hkymstr/CAN_Pressure/k_type_emf_plot.png

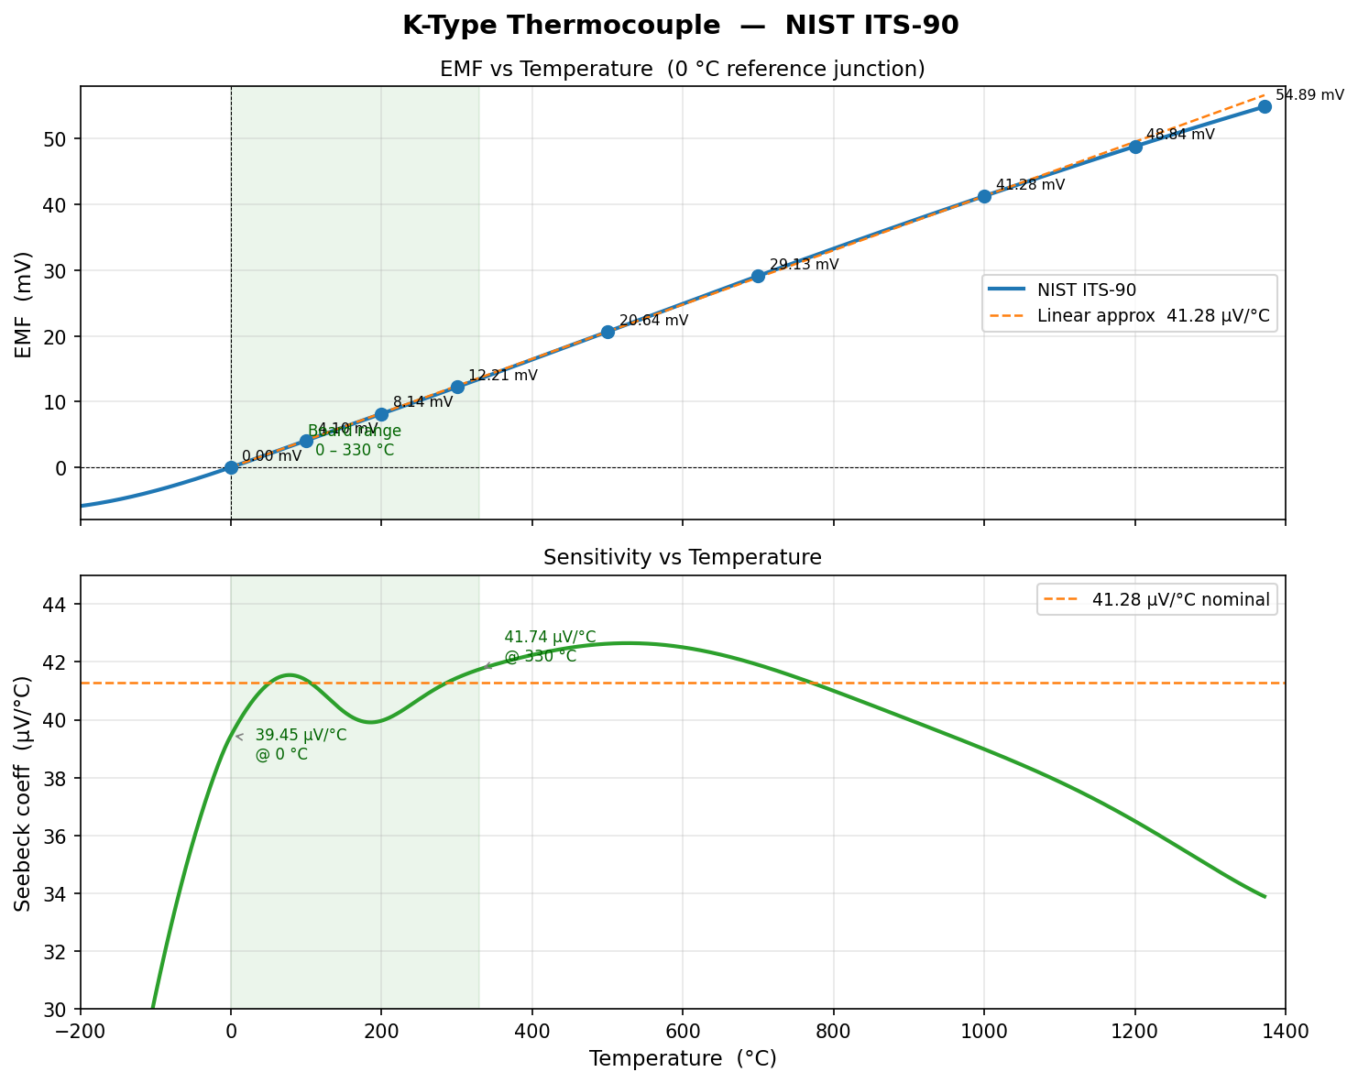
k_type_emf_plot.png
