hkymstr/CAN_Pressure/CAN_adc.pdf

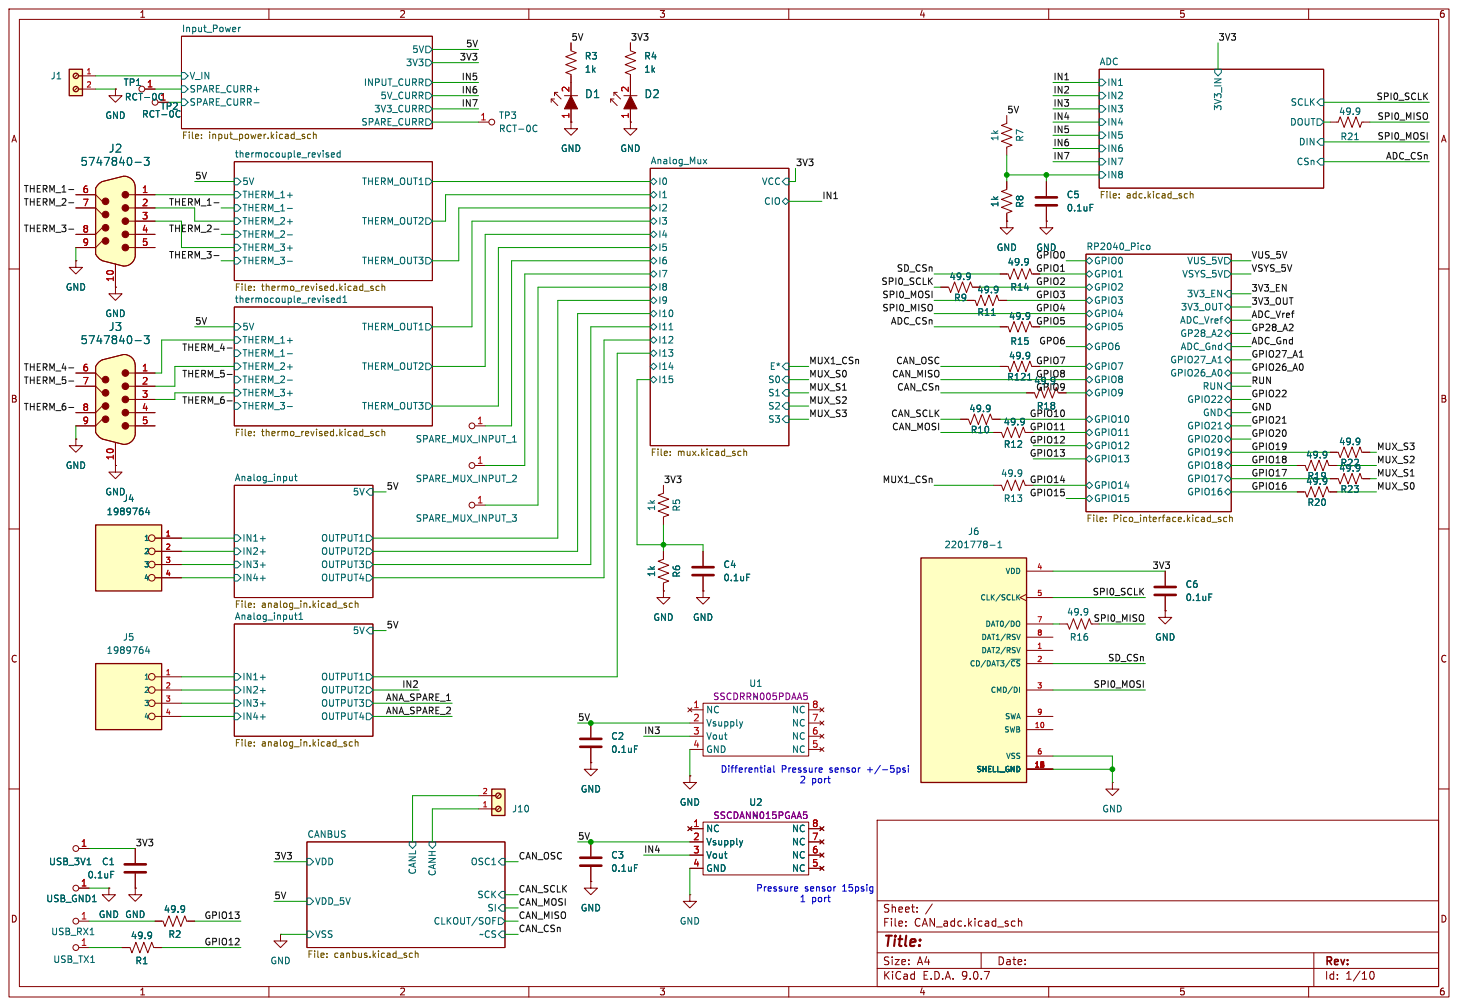
[picture p2: page 1]

Id: 1/10 Title: File: CAN_adc.kicad_sch Sheet: /

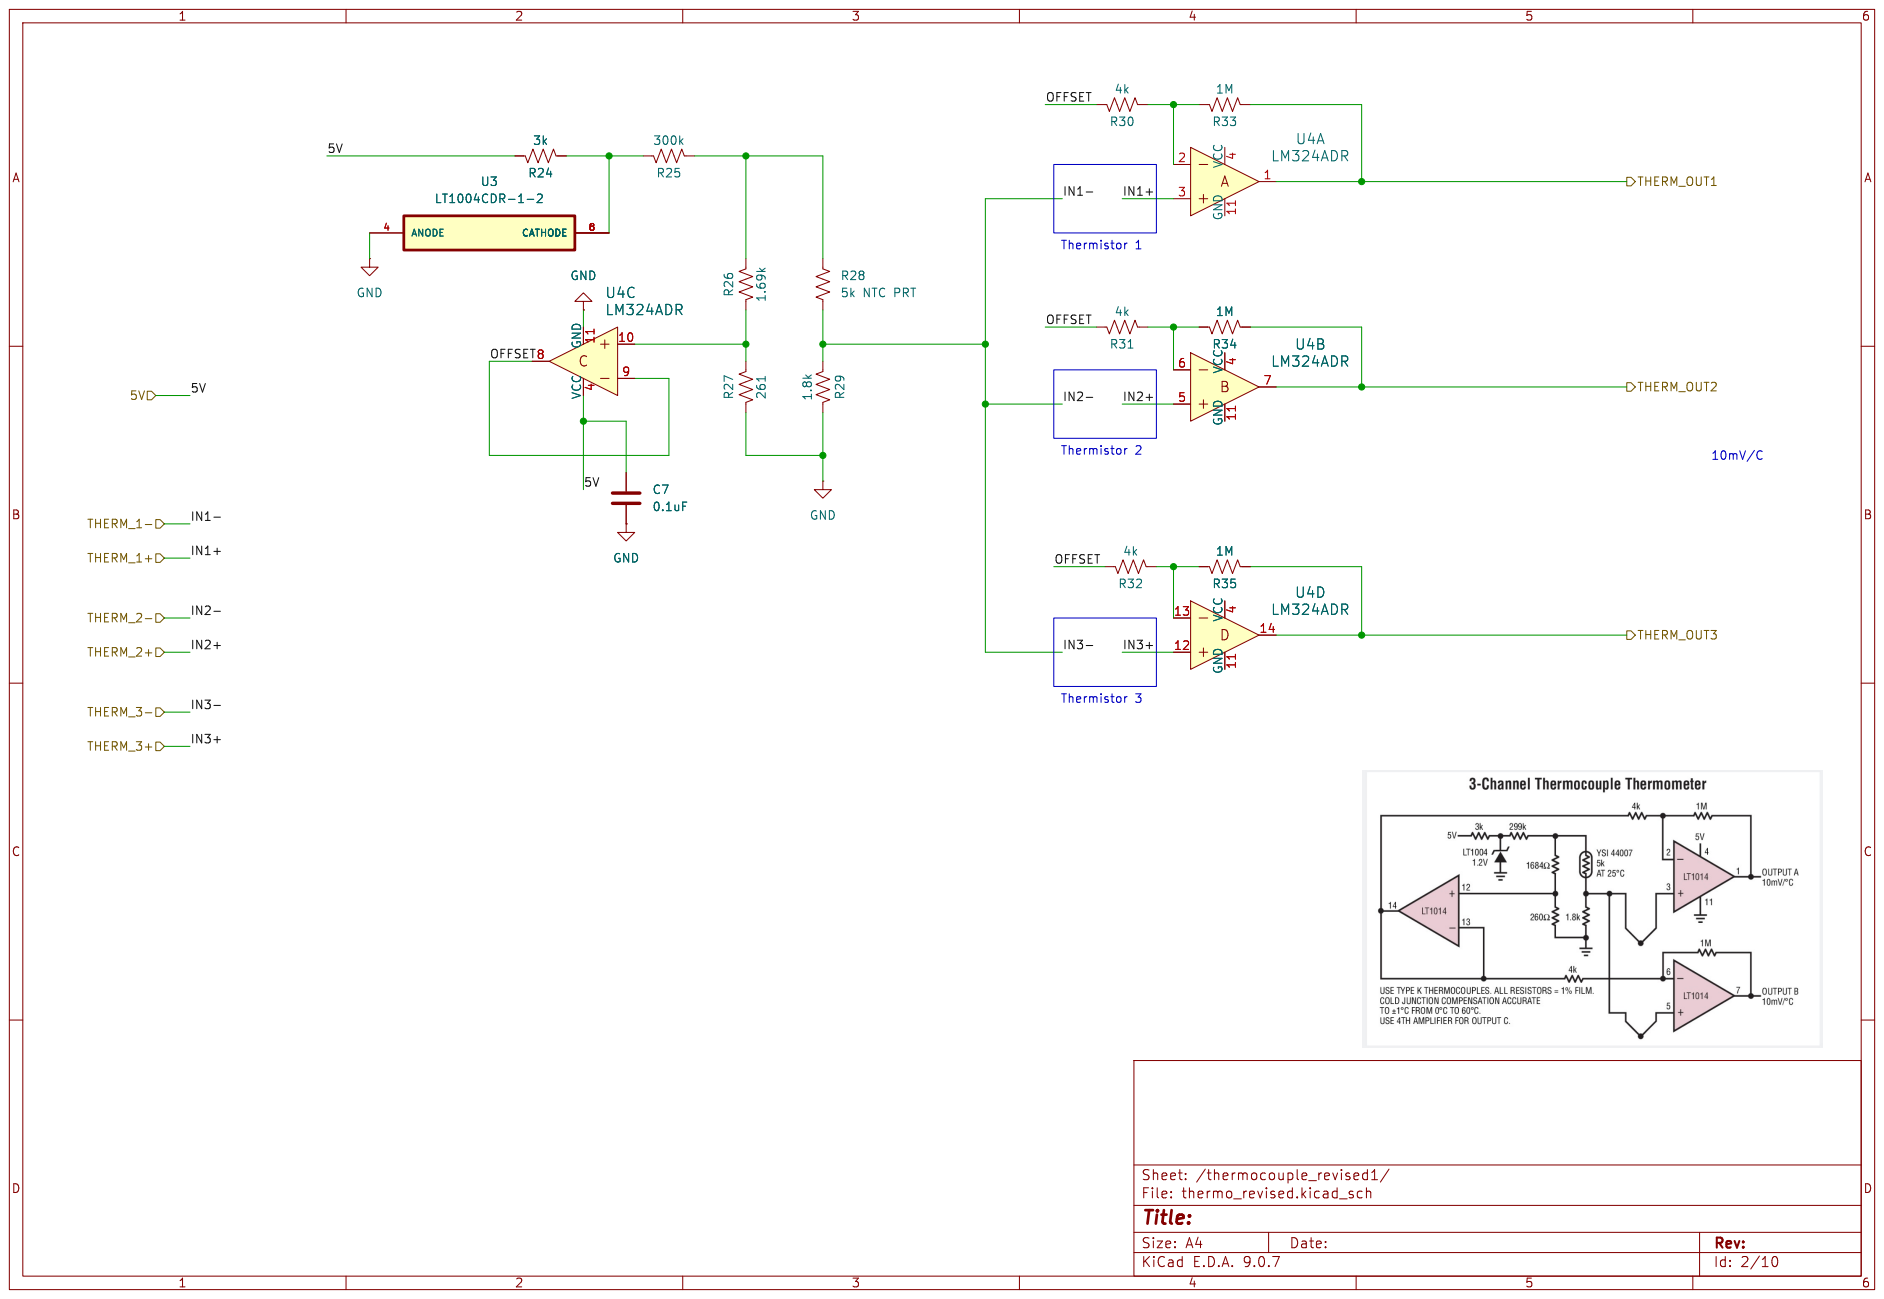
[picture p3: page 2]

Id: 2/10 Title: File: thermo_revised.kicad_sch Sheet: /thermocouple_revised1/

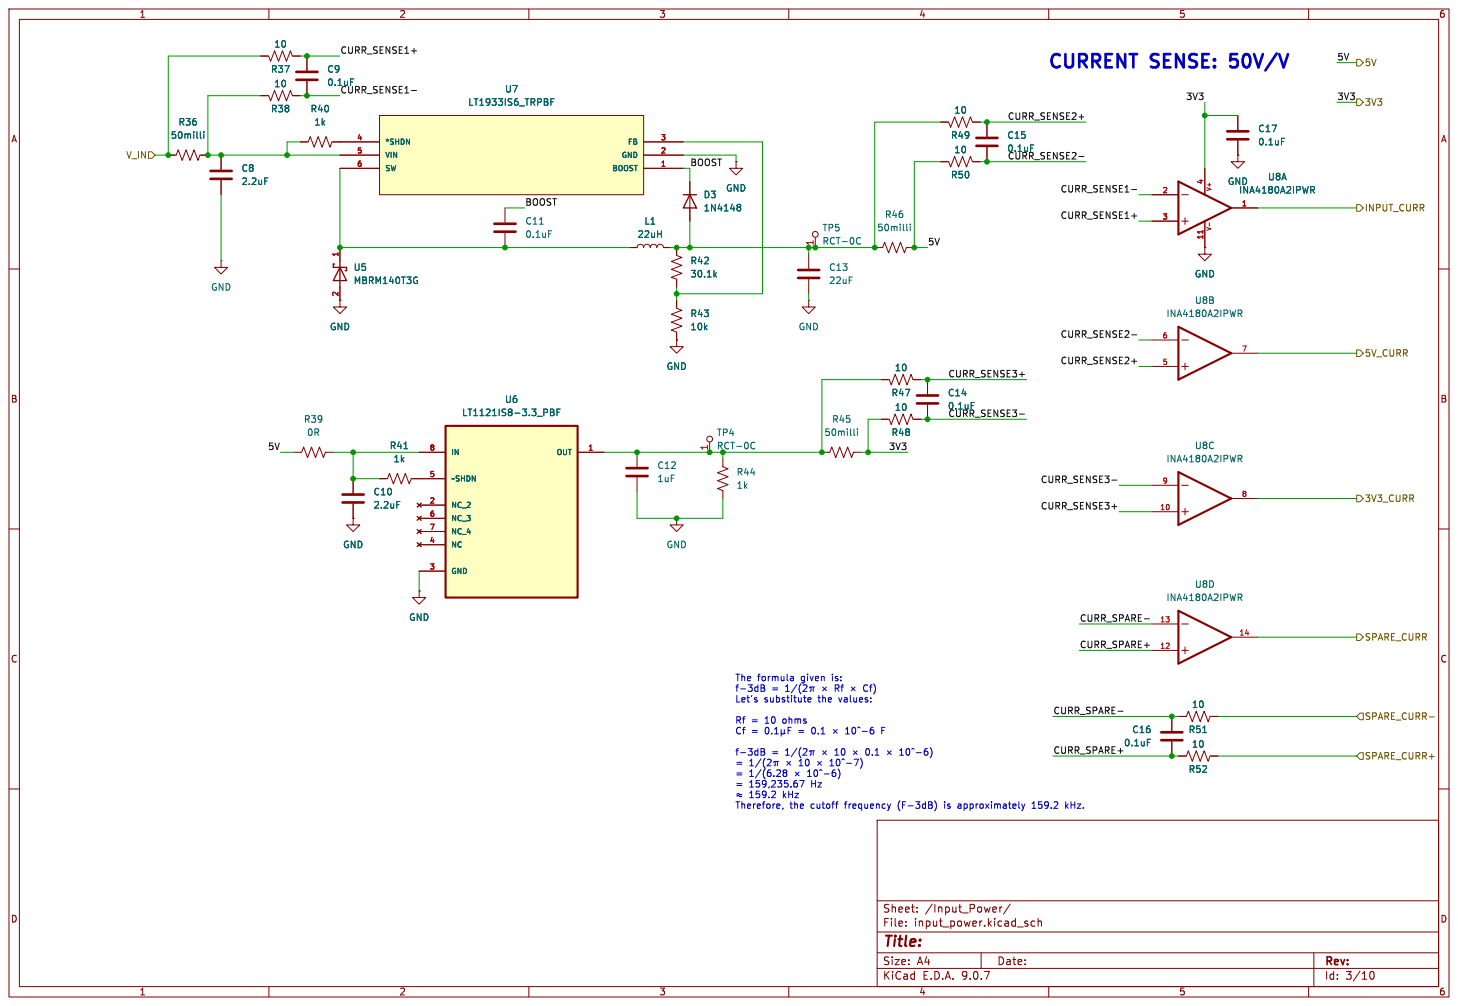
[picture p4: page 3]

Id: 3/10 Title: File: input_power.kicad_sch Sheet: /Input_Power/

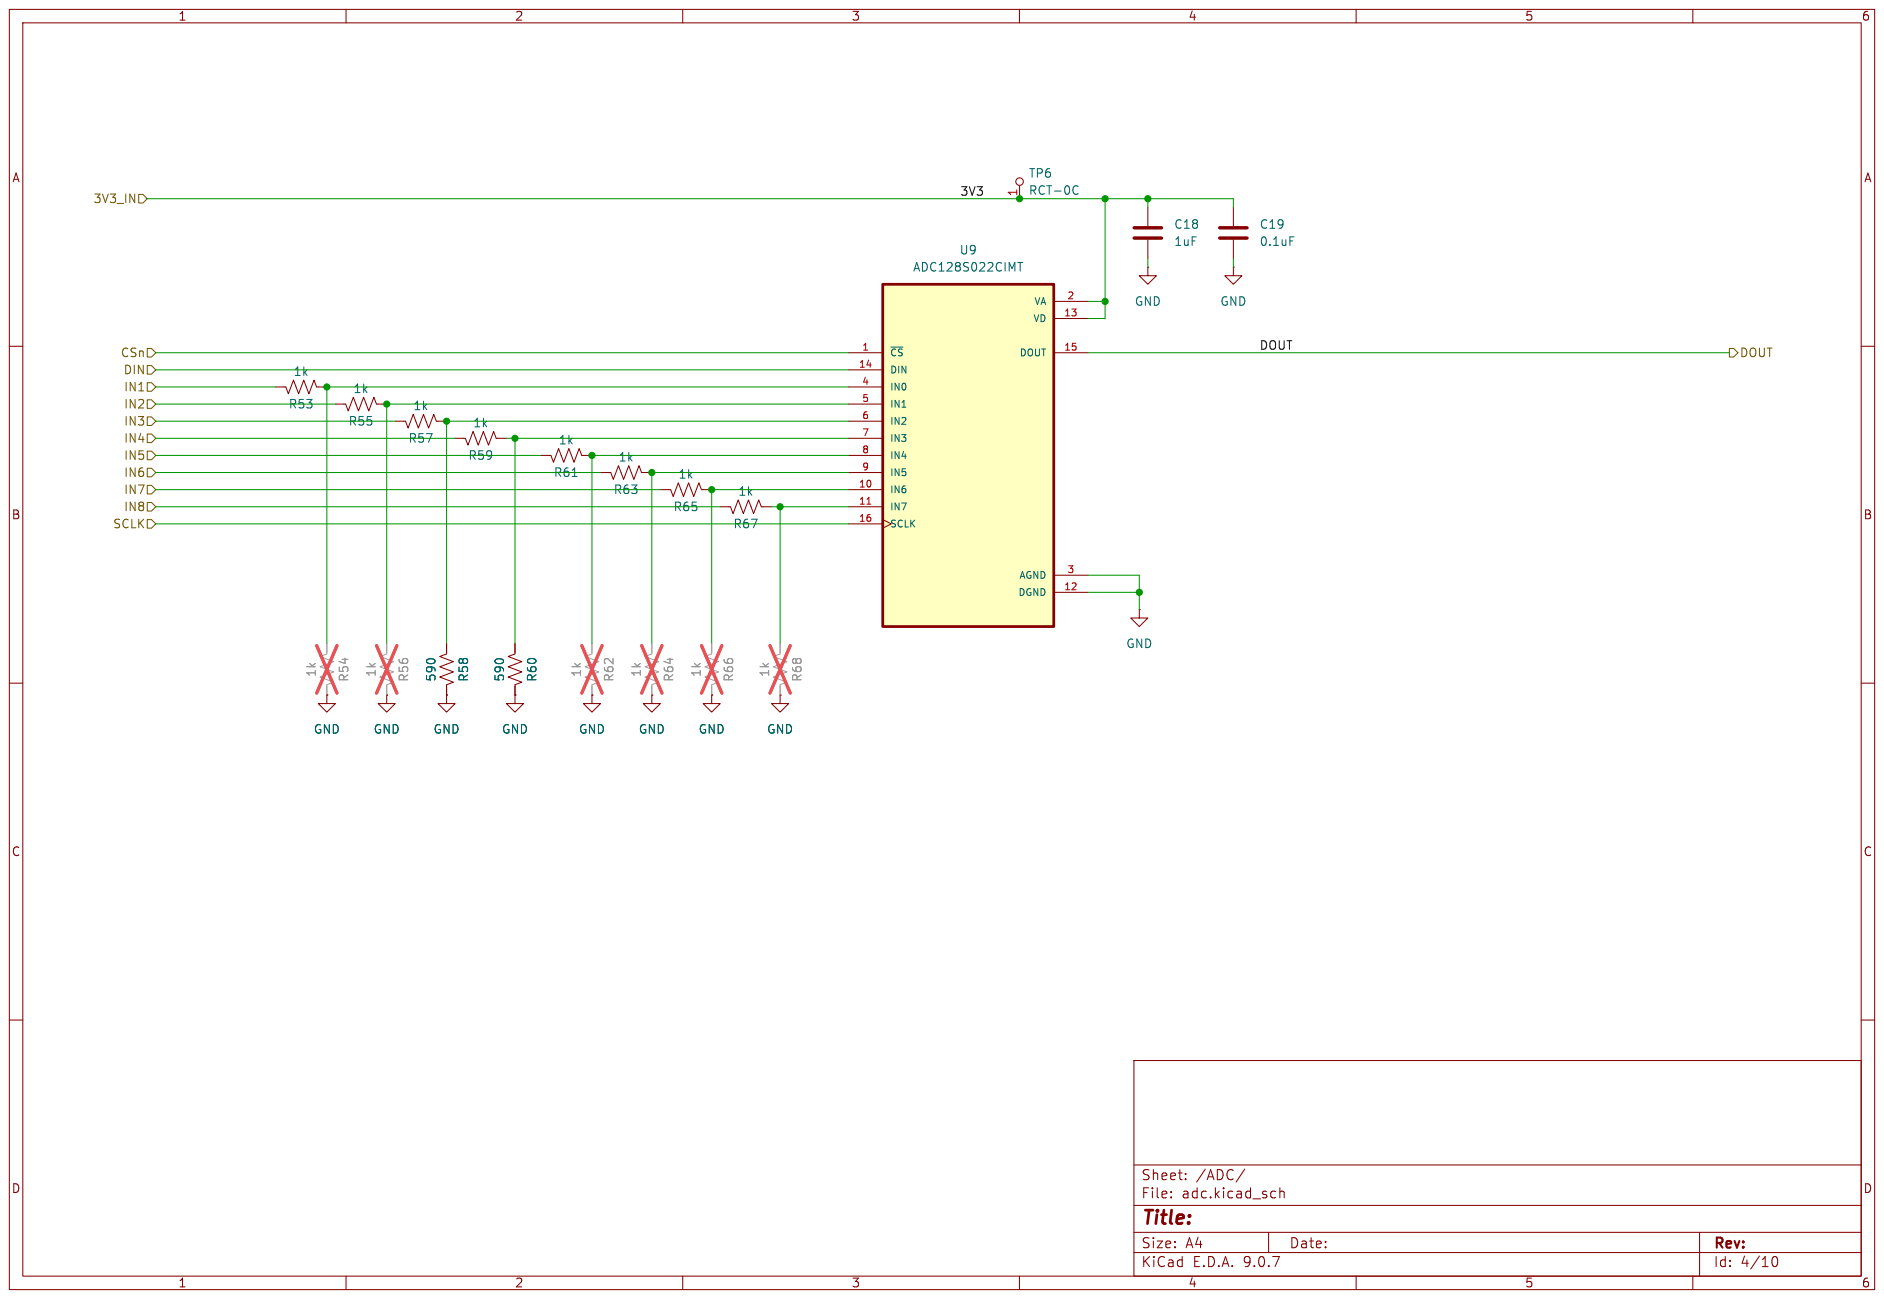
[picture p5: page 4]

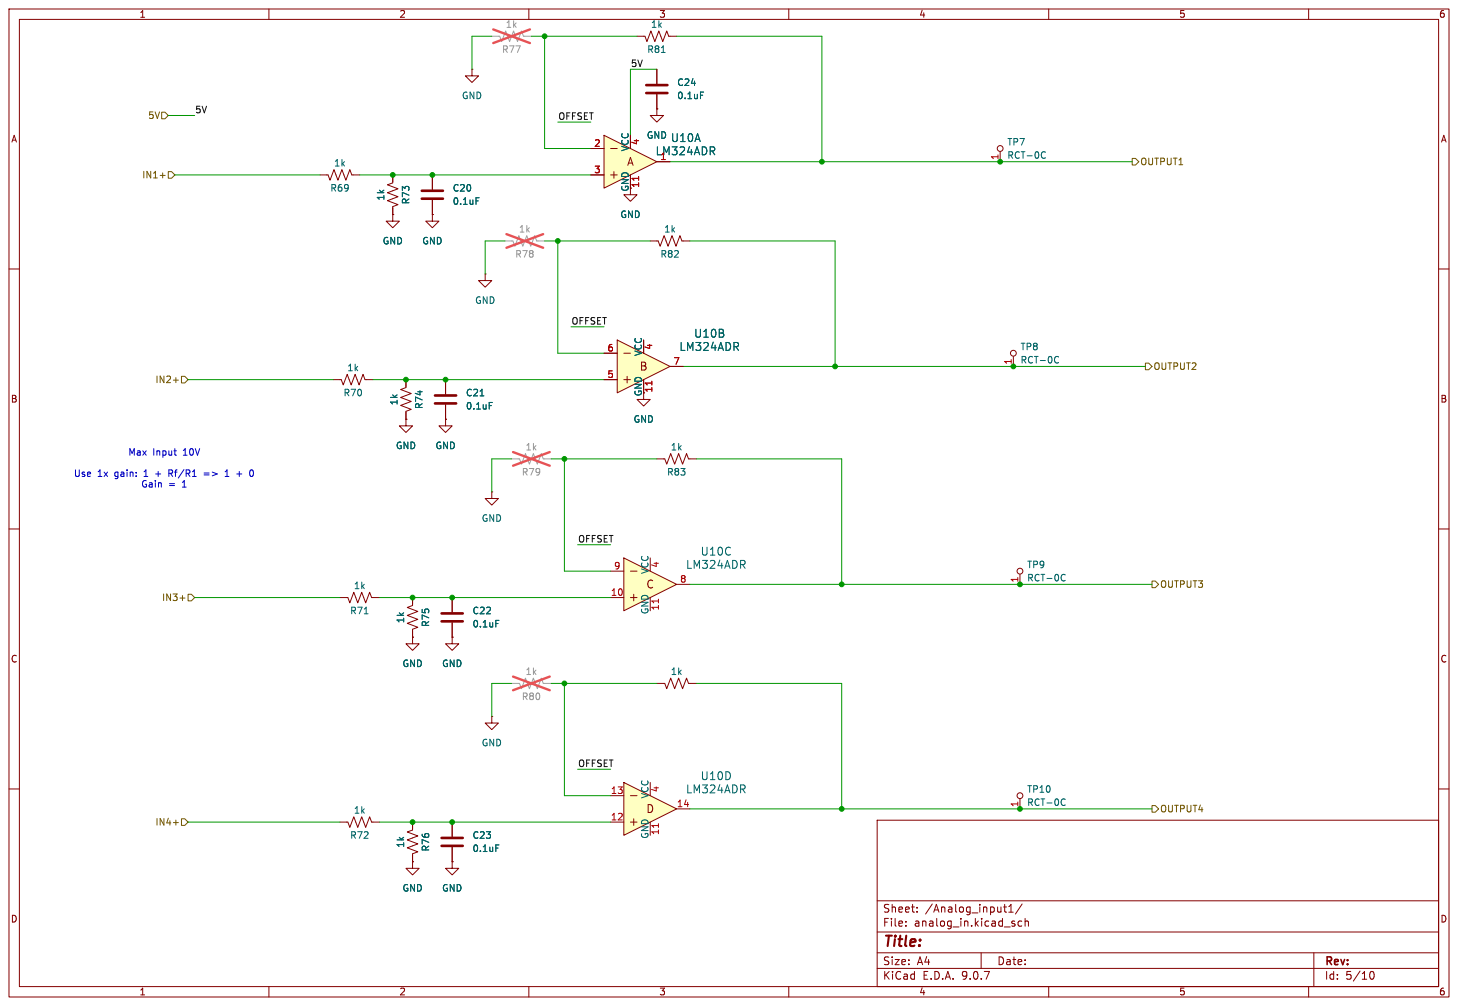
[picture p6: page 5]

Id: 5/10 Title: File: analog_in.kicad_sch Sheet: /Analog_input1/ 1k R72

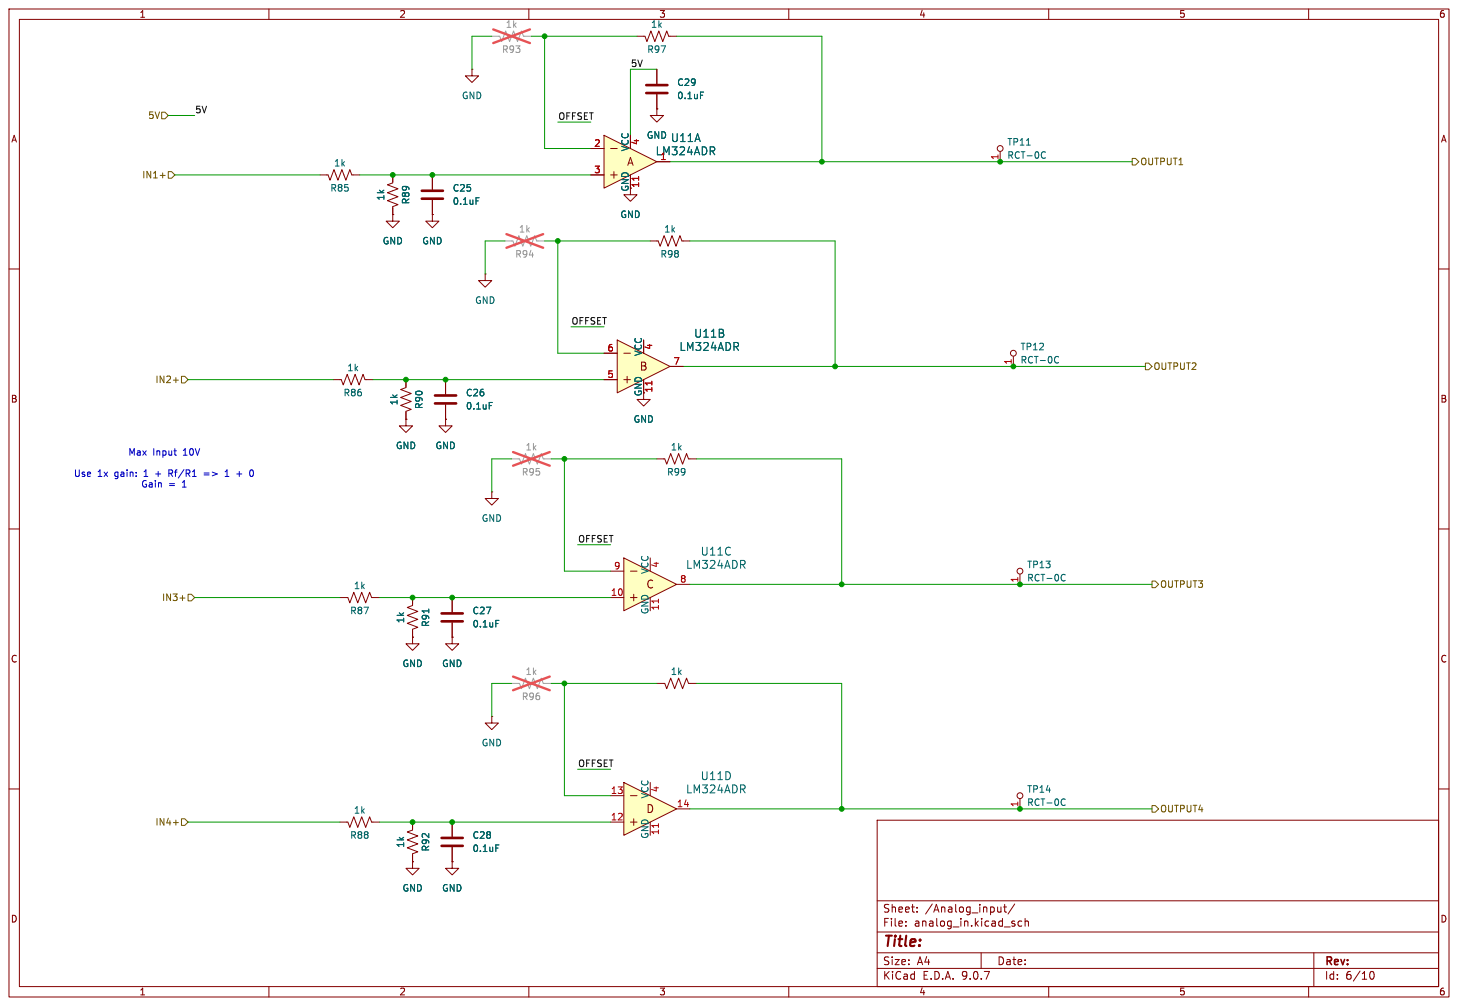
[picture p7: page 6]

Id: 6/10 Title: File: analog_in.kicad_sch Sheet: /Analog_input/ C 9

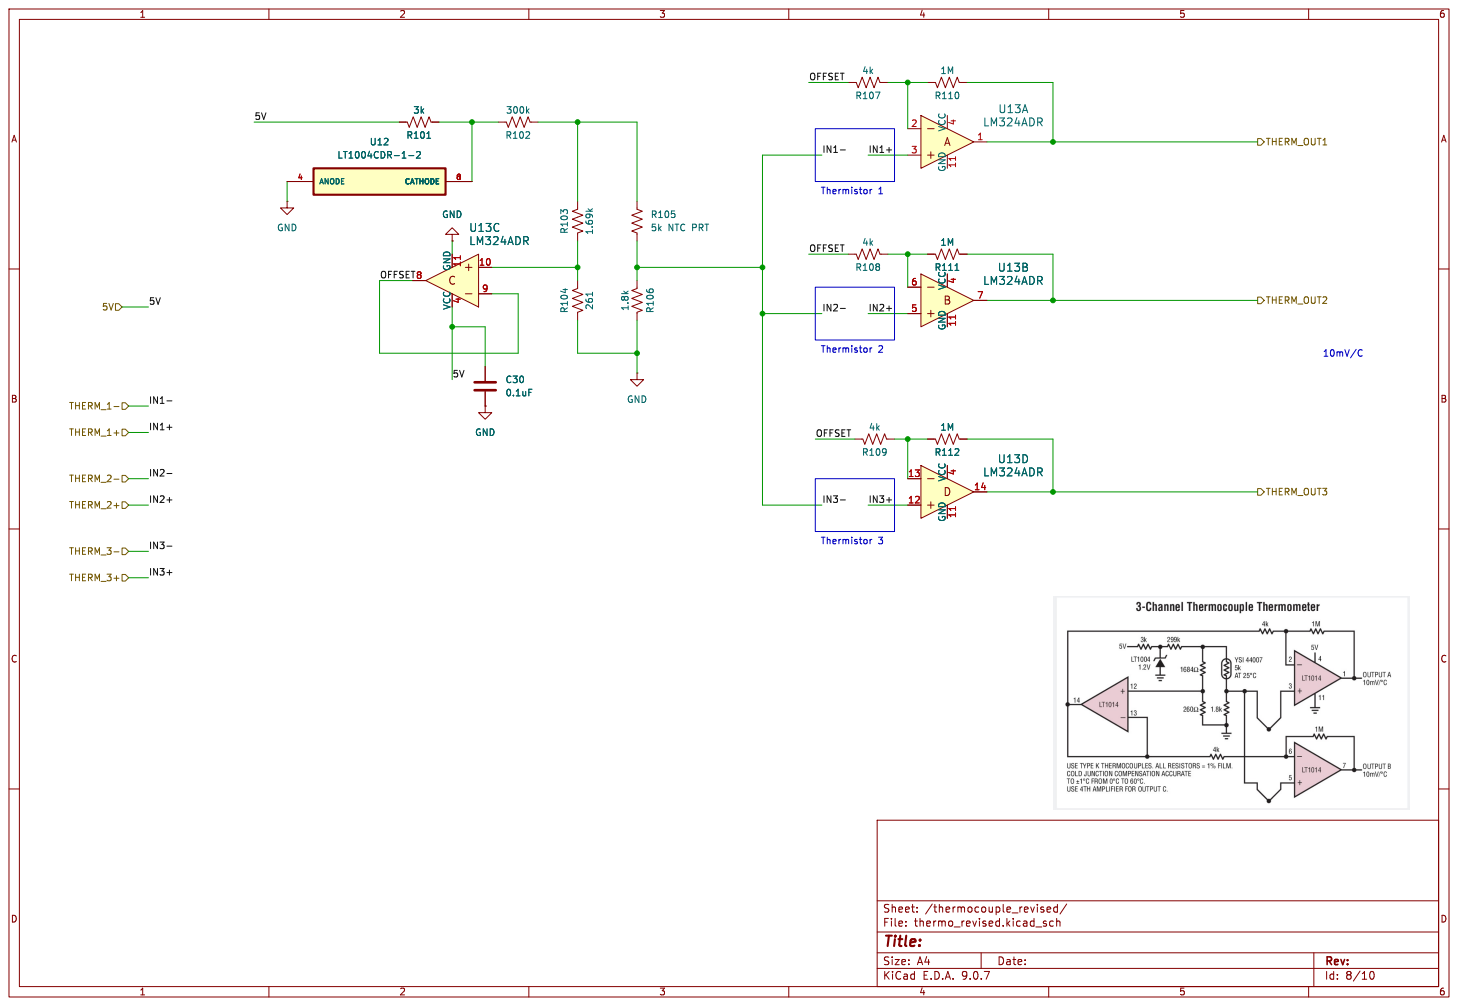
[picture p8: page 7]

Id: 8/10 Title: File: thermo_revised.kicad_sch Sheet: /thermocouple_revised/

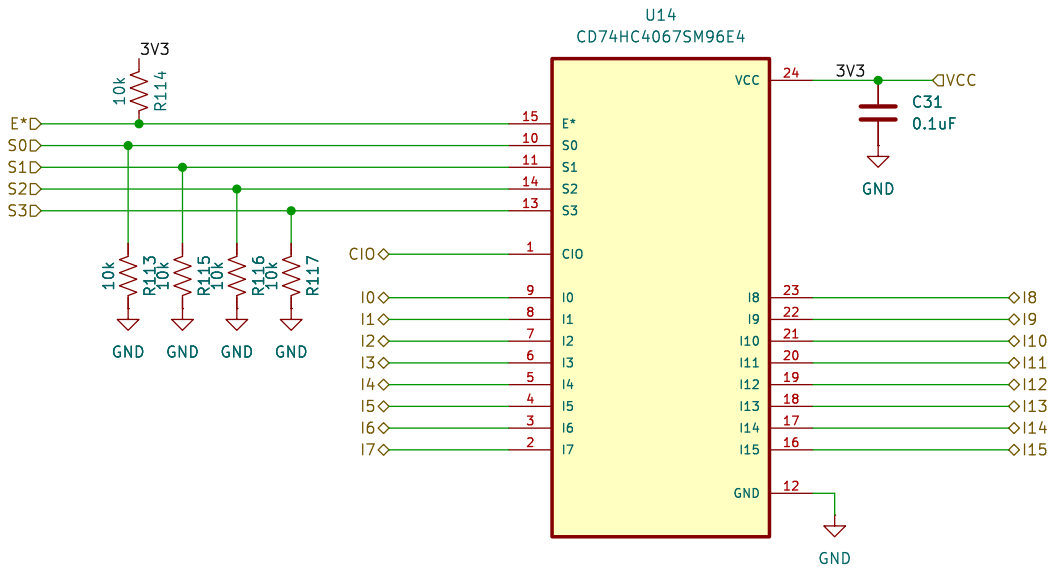
[picture p9: page 8]

Id: 9/10 Title: File: mux.kicad_sch Sheet: /Analog_Mux/ GND

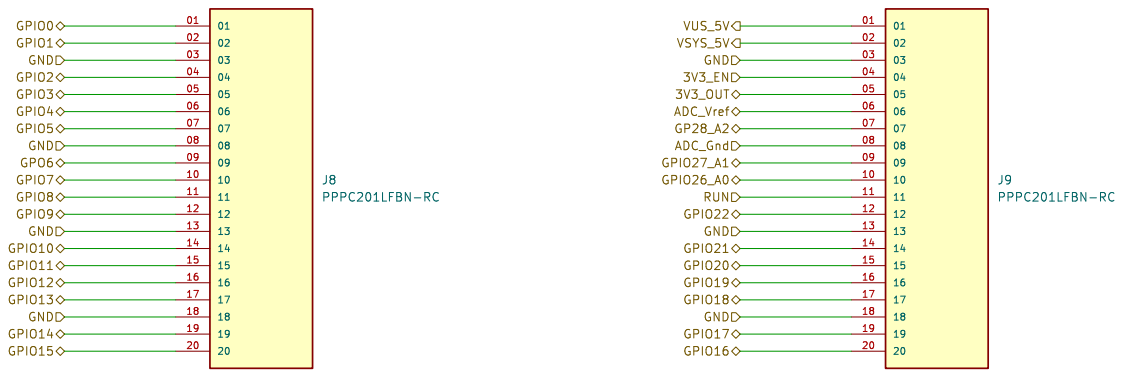
[picture p10: page 9]

3V3_OUT ADC_Vref VUS_5V GPIO16 GPIO18 GND GPIO17 GPIO19 GPIO20 GPIO21 GPIO3 GPIO15 GPIO10 GPIO12 GPIO13 GPIO14 GPIO11 GND GPIO5 GPIO2 GND GPIO4 GPIO1 GPIO0 GND GND GPIO8 GPO6 GPIO7

Id: 9/10 Title: File: Pico_interface.kicad_sch Sheet: /RP2040_Pico/

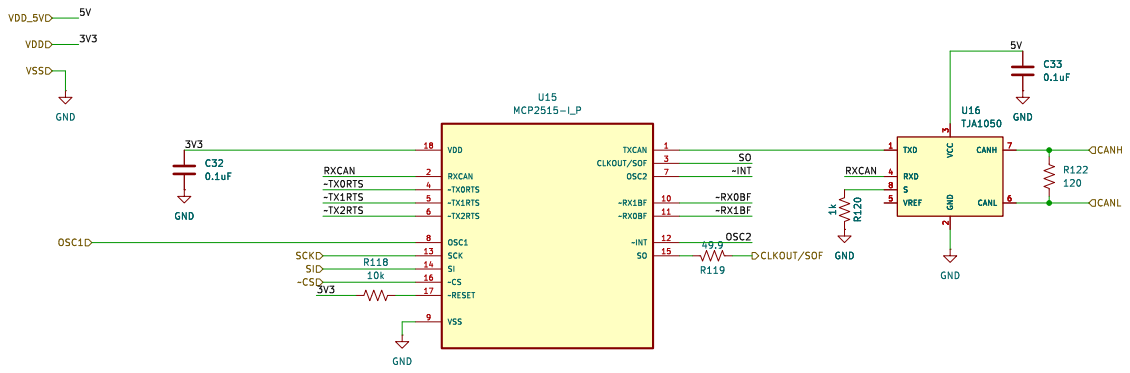
[picture p11: page 10]

2 CANH 7 CANL 6 U16 TJA1050 GND R120 1k GND

Id: 10/10 Title: File: canbus.kicad_sch Sheet: /CANBUS/ GND
