hkymstr/CAN_Pressure/can_monitor.py

#!/usr/bin/env python3
"""
CAN Pressure Board — Serial Monitor and Data Logger

Connects to the board's USB-CDC port, displays live telemetry, and logs
all data rows to a timestamped CSV file.

Data rows from the board are prefixed with '$DATA,' — all other lines
(boot messages, table display, menu text) are printed as-is and not logged.

Usage examples:
    python can_monitor.py --port COM3
    python can_monitor.py --port /dev/ttyACM0 --output run1.csv
    python can_monitor.py --port COM3 --quiet
    python can_monitor.py --list

Requirements:
    pip install pyserial
"""

import argparse
import csv
import datetime
import sys
import time

try:
    import serial
    import serial.tools.list_ports
except ImportError:
    print("ERROR: pyserial not installed.  Run:  pip install pyserial")
    sys.exit(1)

# ---------------------------------------------------------------------------
# Channel metadata — must match firmware _OBD_CHANNELS
# ---------------------------------------------------------------------------

CHANNELS = [
    # CH1–6: thermocouple inputs (10 mV/°C amp → 0–330 °C over 0–3.3 V)
    ("Temperature_1",  "C",      0,  330),
    ("Temperature_2",  "C",      0,  330),
    ("Temperature_3",  "C",      0,  330),
    ("Temperature_4",  "C",      0,  330),
    ("Temperature_5",  "C",      0,  330),
    ("Temperature_6",  "C",      0,  330),
    # CH7–9: spare MUX inputs (unconnected)
    ("Spare_1",        "V",      0,  3.3),
    ("Spare_2",        "V",      0,  3.3),
    ("Spare_3",        "V",      0,  3.3),
    # CH10–14: analog inputs (0.5 resistor divider → ×2 → 0–6.6 V)
    ("Analog_In_1",    "V",      0,  6.6),
    ("Analog_In_2",    "V",      0,  6.6),
    ("Analog_In_3",    "V",      0,  6.6),
    ("Analog_In_4",    "V",      0,  6.6),
    ("Analog_In_5",    "V",      0,  6.6),
    # CH15: spare (unused)
    ("Spare_4",        "V",      0,  3.3),
    # CH16: 3.3 V rail monitor via 0.5 resistor divider (×2 to recover voltage)
    ("Voltage_3V3",    "V",      0,  6.6),
    # CH17: analog input (cont., 0.5 resistor divider → ×2 → 0–6.6 V)
    ("Analog_In_6",    "V",      0,  6.6),
    # CH18: differential pressure, 0.5–4.5 V output, 2.5 V = 0 psid, ±30 psi span
    #       1 kΩ/590 Ω divider → k=0.37107; at 2.5 V sensor → 0.927 V ADC (raw≈1151)
    ("Diff_Pressure",  "psi",  -37.5,  95.898),
    # CH19: gauge pressure sensor, 0–4 V output, 0–15 psi, 1 kΩ/590 Ω divider
    ("Pressure",       "psi",   -1.875,  31.474),
    # CH20–22: current monitors (INA4180A2, 50 V/V, 50 mΩ shunt → 0–1.32 A)
    ("Input_Current",  "A",      0, 1.32),
    ("Curr_5V",        "A",      0, 1.32),
    ("Curr_3V3",       "A",      0, 1.32),
    # CH23: 5 V rail via 0.5 divider (×2 recovery → 0–6.6 V)
    ("Voltage_5V",     "V",      0,  6.6),
]

NUM_CH       = len(CHANNELS)
CH_NAMES     = [c[0] for c in CHANNELS]
CH_UNITS     = [c[1] for c in CHANNELS]
CH_MINS      = [c[2] for c in CHANNELS]
CH_MAXS      = [c[3] for c in CHANNELS]

# Indices used for derived power calculations
IDX_VOLT_5V  = 22   # CH23 Voltage_5V
IDX_CURR_5V  = 20   # CH21 Curr_5V
IDX_VOLT_3V3 = 15   # CH16 Voltage_3V3
IDX_CURR_3V3 = 21   # CH22 Curr_3V3

# Compact display indices (updated to match current channel map)
IDX_TEMP1    = 0    # CH1  Temperature_1
IDX_DIFF_P   = 17   # CH18 Diff_Pressure
IDX_PRESS    = 18   # CH19 Pressure

# Channel labels per CAN frame (4 channels × uint16 big-endian = 8 bytes each)
_CAN_FRAME_LABELS = [
    "Temp_1..4",
    "Temp_5..6, Spare_1..2",
    "Spare_3, Analog_1..3",
    "Analog_4..5, Spare_4, V_3V3",
    "Analog_6, dP, P, I_in",
    "I_5V, I_3V3, V_5V, pad",
]

# ---------------------------------------------------------------------------
# Helpers
# ---------------------------------------------------------------------------

def raw_to_scaled(raw, mn, mx):
    """Convert 12-bit raw count to engineering units."""
    if mx == mn:
        return None
    return mn + (int(raw) / 4095.0) * (mx - mn)


def compute_power(scaled_vals):
    """Return (power_5v_W, power_3v3_W) derived from voltage and current channels."""
    v5   = scaled_vals[IDX_VOLT_5V]
    i5   = scaled_vals[IDX_CURR_5V]
    v3   = scaled_vals[IDX_VOLT_3V3]
    i3   = scaled_vals[IDX_CURR_3V3]
    p5   = v5  * i5  if (v5  is not None and i5  is not None) else None
    p3   = v3  * i3  if (v3  is not None and i3  is not None) else None
    return p5, p3


def format_can_frames(raw_vals):
    """Reconstruct 6 CAN frames (0x200–0x205) from raw ADC values as displayable tuples."""
    frames = []
    for msg_idx in range(6):
        payload = []
        for j in range(4):
            ch = msg_idx * 4 + j
            val = int(raw_vals[ch]) if ch < NUM_CH else 0
            payload.append((val >> 8) & 0xFF)
            payload.append(val & 0xFF)
        hex_str = " ".join(f"{b:02X}" for b in payload)
        frames.append((f"0x{0x200 + msg_idx:03X}", hex_str, _CAN_FRAME_LABELS[msg_idx]))
    return frames


def list_ports():
    ports = list(serial.tools.list_ports.comports())
    if not ports:
        print("No serial ports found.")
        return
    print("Available serial ports:")
    for p in sorted(ports):
        print(f"  {p.device:<15}  {p.description}")


def open_port(port, baud, retries=5):
    for attempt in range(1, retries + 1):
        try:
            ser = serial.Serial(port, baud, timeout=2)
            print(f"Connected to {port} at {baud} baud.")
            return ser
        except serial.SerialException as exc:
            wait = 2 ** attempt
            print(f"  [{attempt}/{retries}] {exc}  — retrying in {wait}s")
            if attempt < retries:
                time.sleep(wait)
    print("Could not open port.  Exiting.")
    sys.exit(1)


def auto_filename():
    ts = datetime.datetime.now().strftime("%Y%m%d_%H%M%S")
    return f"can_pressure_{ts}.csv"


# ---------------------------------------------------------------------------
# Live display helpers
# ---------------------------------------------------------------------------

_CLEAR = "\033[2J\033[H"   # ANSI clear screen + cursor home

def print_live_table(timestamp, raw_vals, fw_version=None):
    """Render a full-screen table of all 23 channels plus derived power rows."""
    sep  = "=" * 62
    dash = "-" * 62
    print(_CLEAR, end="")
    print(sep)
    ver_str = f"  |  FW {fw_version}" if fw_version else ""
    print(f"  CAN Pressure Board  |  {timestamp}{ver_str}")
    print(sep)
    print(f"  {'CH':>2}  {'Channel':<18}  {'Raw':>5}  {'Value':>10}  Unit")
    print(dash)
    scaled_vals = [raw_to_scaled(raw_vals[i], CH_MINS[i], CH_MAXS[i])
                   for i in range(NUM_CH)]
    for i, raw in enumerate(raw_vals):
        scaled  = scaled_vals[i]
        val_str = f"{scaled:10.3f}" if scaled is not None else f"{'---':>10}"
        print(f"  {i+1:>2}  {CH_NAMES[i]:<18}  {int(raw):>5}  {val_str}  {CH_UNITS[i]}")
    print(dash)
    p5, p3 = compute_power(scaled_vals)
    p5_str = f"{p5:10.3f}" if p5 is not None else f"{'---':>10}"
    p3_str = f"{p3:10.3f}" if p3 is not None else f"{'---':>10}"
    print(f"  {'':2}  {'Power_5V':<18}  {'':>5}  {p5_str}  W")
    print(f"  {'':2}  {'Power_3V3':<18}  {'':>5}  {p3_str}  W")
    print(dash)
    print(f"  CAN Bus Stream  (0x200–0x205 @ 500 kbps, 4 ch × uint16 big-endian)")
    print(dash)
    for can_id_str, hex_str, label in format_can_frames(raw_vals):
        print(f"  {can_id_str}  {hex_str}  {label}")
    print(sep)


def print_live_compact(timestamp, raw_vals, row_count):
    """One-line summary printed inline (for non-ANSI terminals)."""
    scaled = [raw_to_scaled(raw_vals[i], CH_MINS[i], CH_MAXS[i]) for i in range(NUM_CH)]
    temp1  = scaled[IDX_TEMP1]
    dp     = scaled[IDX_DIFF_P]
    press  = scaled[IDX_PRESS]
    p5, p3 = compute_power(scaled)
    t_str  = f"{temp1:5.1f}C"   if temp1 is not None else "  --- "
    dp_str = f"{dp:5.2f}psi"    if dp    is not None else " ---  "
    p_str  = f"{press:6.1f}psi" if press is not None else "  --- "
    p5_str = f"{p5:5.2f}W"      if p5   is not None else " ---  "
    p3_str = f"{p3:5.2f}W"      if p3   is not None else " ---  "
    print(f"\r{timestamp}  T1={t_str}  dP={dp_str}  P={p_str}  "
          f"P5={p5_str}  P3={p3_str}  [{row_count}]",
          end="", flush=True)


# ---------------------------------------------------------------------------
# Main
# ---------------------------------------------------------------------------

def run(port, baud, output_file, quiet, full_screen):
    ser = open_port(port, baud)

    if output_file is None:
        output_file = auto_filename()

    print(f"Logging to: {output_file}")
    if not quiet:
        mode = "full-screen table" if full_screen else "compact one-line"
        print(f"Display:    {mode}")
    print("Press Ctrl-C to stop.\n")

    row_count  = 0
    fw_version = None

    with open(output_file, "w", newline="") as f:
        writer = csv.writer(f)
        # Header: Timestamp + one column per channel (raw) + one per channel (scaled)
        raw_header    = [f"{n}_raw" for n in CH_NAMES]
        scaled_header = [f"{n}_{u}" if u else n for n, u, *_ in CHANNELS]
        writer.writerow(["Timestamp"] + raw_header + scaled_header +
                        ["Power_5V_W", "Power_3V3_W"])
        f.flush()

        try:
            while True:
                try:
                    line = ser.readline().decode("utf-8", errors="replace").rstrip("\r\n")
                except serial.SerialException:
                    print("\nPort disconnected — reconnecting...")
                    ser.close()
                    time.sleep(2)
                    ser = open_port(port, baud)
                    continue

                if not line:
                    continue

                if line.startswith("$DATA,"):
                    # Parse: $DATA,<timestamp>,<v0>,<v1>,...,<v22>
                    parts = line[6:].split(",")
                    if len(parts) < NUM_CH + 1:
                        continue   # malformed line

                    timestamp = parts[0]
                    try:
                        raw_vals = [int(p) for p in parts[1 : NUM_CH + 1]]
                    except ValueError:
                        continue

                    scaled_vals = [
                        raw_to_scaled(r, CH_MINS[i], CH_MAXS[i])
                        for i, r in enumerate(raw_vals)
                    ]
                    scaled_strs = [
                        f"{v:.4f}" if v is not None else "" for v in scaled_vals
                    ]
                    p5, p3 = compute_power(scaled_vals)
                    p5_str = f"{p5:.4f}" if p5 is not None else ""
                    p3_str = f"{p3:.4f}" if p3 is not None else ""

                    writer.writerow([timestamp] + raw_vals + scaled_strs +
                                    [p5_str, p3_str])
                    f.flush()
                    row_count += 1

                    if not quiet:
                        if full_screen:
                            print_live_table(timestamp, raw_vals, fw_version)
                        else:
                            print_live_compact(timestamp, raw_vals, row_count)

                elif line.startswith("$CAN,"):
                    parts = line[5:].split(",", 2)
                    if len(parts) == 3 and parts[1].strip() == "0x1FF":
                        try:
                            hb = parts[2].strip().split()
                            fw_version = "v{}.{}.{}".format(
                                int(hb[0], 16), int(hb[1], 16), int(hb[2], 16))
                        except (IndexError, ValueError):
                            pass

                else:
                    # Non-data line (boot message, table header, menu text)
                    if not quiet:
                        if not full_screen:
                            print()   # newline after compact row
                        print(line)

        except KeyboardInterrupt:
            if not quiet and not full_screen:
                print()
            print(f"\nStopped.  {row_count} rows written to {output_file}")
        finally:
            ser.close()


def main():
    parser = argparse.ArgumentParser(
        description="CAN Pressure Board — serial monitor and data logger",
        formatter_class=argparse.RawDescriptionHelpFormatter,
        epilog="""
examples:
  %(prog)s --port COM3
  %(prog)s --port /dev/ttyACM0 --output run1.csv
  %(prog)s --port COM3 --full-screen
  %(prog)s --port COM3 --quiet --output background.csv
  %(prog)s --list
        """)

    parser.add_argument("--port",  "-p",
                        help="Serial port  (e.g. COM3 or /dev/ttyACM0)")
    parser.add_argument("--baud",  "-b", type=int, default=115200,
                        help="Baud rate (default: 115200)")
    parser.add_argument("--output", "-o",
                        help="Output CSV file  (default: auto-timestamped)")
    parser.add_argument("--quiet", "-q", action="store_true",
                        help="Suppress all screen output — log only")
    parser.add_argument("--full-screen", "-f", action="store_true",
                        help="Clear screen and redraw full channel table each second")
    parser.add_argument("--list", "-l", action="store_true",
                        help="List available serial ports and exit")

    args = parser.parse_args()

    if args.list:
        list_ports()
        return

    if not args.port:
        parser.print_help()
        print("\nERROR: --port is required.")
        print()
        list_ports()
        sys.exit(1)

    run(args.port, args.baud, args.output, args.quiet, args.full_screen)


if __name__ == "__main__":
    main()
