hkymstr/CAN_Pressure/(commit log)

2025-02-23 KiCAD file for layout
2025-03-02 Added CANBUS_pressure_monitor.drawio
2025-03-02 Create software_can_micro_python
    micro python code for raspberry pi pico
2025-03-02 Create software_can_circuit_python.py
    circuit python implmentation
2026-05-05 Implement all 8 firmware requirements
    - Fix CAN IDs to 0x200-0x205 (was 0x100+)
    - Fix MCP2515 bit timing: correct CNF1/2/3 for 500/250/125/1000 kbps @ 8 MHz
    - Enforce 5 Hz sampling with ticks_diff timing (was free-running)
    - Fix ADC channel index bug: adc_data[0..15]=MUX, [16..22]=direct ADC IN1-7
    - Fix ADC128S022 command byte: channel in DIN[13:11] not DIN[14:12]
    - Fix SPI ADC reads to use write_readinto (full-duplex); prime pipeline per MUX switch
    - Fix MCP2515 TX: single CS transaction for LOAD_TX0 + header + data
    - Add USB-CDC menu (Enter key): set RTC time, set CAN baud rate
    - Add RP2040 RTC timestamping on all log rows
    - Fix SD log format to CAN log: Time Stamp,ID,Extended,Bus,LEN,D1..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
    [software_can_micro_python.py]
2026-05-05 Add comprehensive README documentation
    Covers pin assignments, channel map, CAN frame layout, SD log format,
    OBD file format, firmware defaults, and menu interface usage.
    https://claude.ai/code/session_01437NfnwRvxVYxq9oxSTwrE
2026-05-05 Expand README with full design documentation
    Adds complete hardware architecture, BOM for all key ICs, connector
    reference table, detailed signal chain description, full 23-channel map
    with sensor assignments and engineering-unit ranges, CAN frame layout,
    SD card file formats with decode examples, power supply topology,
    MCP2515 bit-timing derivation, firmware deploy instructions, and
    serial menu usage guide.
    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
2026-05-06 Add 1 Hz serial telemetry display and PC monitor/logger
    Firmware (software_can_micro_python.py):
    - Add DISP_OFF/TABLE/CSV/BOTH display modes, default OFF
    - Print human-readable channel table at 1 Hz (DISP_TABLE)
    - Print $DATA,<timestamp>,<CH1..23> CSV line at 1 Hz (DISP_CSV)
    - DISP_BOTH prints both formats each second
    - Add menu option 3 to cycle display mode; Resume moves to option 4
    - Display timer resets cleanly after menu exit
    PC monitor (can_monitor.py):
    - Parses $DATA, prefixed lines from USB-CDC port
    - Logs timestamped CSV with raw counts + scaled engineering values
    - --full-screen: clears terminal and redraws complete 23-channel table
    - Default compact mode: one rolling line showing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
    [can_monitor.py, software_can_micro_python.py]
2026-05-06 Fix SPI0 corruption when SD card is absent
    sdcard.SDCard() reconfigures the SPI0 bus during its init sequence.
    When no SD card is installed the init raises an exception but leaves
    SPI0 in a wrong baudrate/mode, causing all ADC128S022 reads to return
    0. Reinitialise SPI0 in the except block so the ADC works regardless
    of SD card presence.
    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
    [software_can_micro_python.py]
2026-05-06 Harden ADC reads and add diagnostic script
    - Move sdcard import inside try/except so a missing sdcard.py no
    longer crashes the whole firmware at import time
    - Move SPI0 reinitialisation to a finally block so it always runs
    after _init_sd(), whether the SD card succeeds or fails
    - Fix direct ADC channel reads (IN1-IN7) to use prime+read like
    MUX channels, avoiding any pipeline off-by-one
    - Print firmware version and config at startup for easy confirmation
    - Add test_adc.py standalone diagnostic (mpremote run test_adc.py)
    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
    [software_can_micro_python.py, test_adc.py]
2026-05-06 Add hardware-level ADC diagnostic phases to test_adc.py
    Phase 1 reads MISO as plain GPIO with/without pull to reveal if
    the line is stuck low independent of SPI. Phase 2 compares raw
    SPI bytes with ADC_CS, SD_CS, and no CS asserted to isolate which
    chip (if any) is responding. Phase 3 sweeps multiple SPI speeds.
    Phase 4 loops for scope/logic-analyser probing.
    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
    [test_adc.py]
2026-05-06 Add MISO pin-hunt to ADC diagnostic
    Phase 0 probes every SPI0_RX candidate (GP0/4/6/7/8/16/20) as plain
    GPIO to find which is driven. Phase 1 attempts a SoftSPI read from
    each candidate so the correct MISO pin is identified empirically
    rather than relying on the schematic alone.
    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
    [test_adc.py]
2026-05-06 Update channel map to match actual board signal assignments
    - CH1-6: 6 thermocouple inputs (10 mV/°C amp, 0-330 C range)
    - CH7-9: 3 spare MUX inputs (unconnected)
    - CH10-16: 7 direct analog inputs (0-3.3 V)
    - CH17: differential pressure, 0-15 psi
    - CH18: gauge pressure, 0-150 psi
    - CH19-21: current monitors (INA4180A2 50V/V, 50mΩ shunt, 0-1.32 A)
    - CH22: 5 V rail via 0.5 divider (0-6.6 V)
    - CH23: spare
    Both _OBD_CHANNELS (firmware) and CHANNELS (can_monitor.py) updated.
    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
2026-05-06 Correct channel map: spare at CH15, analog gap, currents shift by one
    CH1-6: Temperature_1..6
    CH7-9: Spare_1..3 (MUX, unconnected)
    CH10-14: Analog_In_1..5
    CH15: Spare_4 (unused)
    CH16-17: Analog_In_6..7
    CH18: Diff_Pressure (0-15 psi)
    CH19: Pressure (0-150 psi)
    CH20: Input_Current (0-1.32 A)
    CH21: Curr_5V (0-1.32 A)
    CH22: Curr_3V3 (0-1.32 A)
    CH23: Voltage_5V (0-6.6 V, 0.5 divider)
    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
    [can_monitor.py, software_can_micro_python.py]
2026-05-07 Add CH16 Voltage_3V3 and derived Power_5V / Power_3V3 telemetry
    CH16 corrected from Analog_In_6 to Voltage_3V3 (3.3V rail via 0.5
    resistor divider, same ×2 recovery as Voltage_5V on CH23).
    Derived power calculations added everywhere telemetry is displayed:
    - Firmware _print_table(): Power_5V and Power_3V3 rows after CH23
    - can_monitor.py full-screen table: same two derived rows
    - can_monitor.py compact one-liner: P5=X.XXW P3=X.XXW fields
    - can_monitor.py CSV: Power_5V_W and Power_3V3_W appended columns
    Formula: P = Voltage_xV (CH16/CH23, 0.5-divider corrected) ×
    Curr_xV (CH21/CH22, INA4180A2 50V/V + 50mΩ shunt)
    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
    [can_monitor.py, software_can_micro_python.py]
2026-05-07 Add MCP2515 CAN loopback diagnostic (test_can.py)
    Resets the MCP2515, verifies config mode, writes and reads back
    CNF1/2/3, enters loopback mode, then sends three test frames
    (0x200, 0x205, 0x123) and checks that each is received back
    with the correct ID and payload. No external CAN bus required.
    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
    [test_can.py]
2026-05-07 Add CAN frame stream panel to full-screen live display
    - can_monitor.py: add format_can_frames() which reconstructs all 6 CAN
    frames (0x200-0x205) as hex strings from raw ADC values; append a
    CAN Bus Stream section below the power rows in print_live_table()
    showing each frame ID, 8 raw bytes, and a short channel label; add
    _CAN_FRAME_LABELS constant; silently absorb $CAN, lines in run() so
    they don't clutter the compact one-line display
    - firmware: emit $CAN,<ts>,0x<id>,<hex bytes> after each frame
    transmission so the stream is visible on a raw serial terminal and
    parsed correctly by the monitor
    Use --full-screen to see decoded telemetry and CAN frame hex side by side.
    https: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
    [can_monitor.py, software_can_micro_python.py]
2026-05-08 Add DBC file for AIM Solo CAN import
    6 messages (0x200–0x205), 23 signals total. Each signal is a 16-bit
    Motorola (big-endian) unsigned integer at 500 kbps. Factors convert
    raw 12-bit ADC counts (0–4095) to engineering units (°C, V, psi, A).
    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
2026-05-08 Add firmware version broadcast on CAN ID 0x1FF
    - Define FW_MAJOR/MINOR/PATCH (2.0.0) and CAN_VERSION_ID=0x1FF
    - _send_version_frame(): packs [major, minor, patch, 0×5] and emits
    a $CAN line; called once at boot then every 10 s
    - Boot banner now includes version number
    - can_monitor.py: parse 0x1FF $CAN frames to extract fw_version;
    display it in the full-screen table header (FW v2.0.0)
    - can_pressure.dbc: add FW_Version message (ID 511) with FW_Major,
    FW_Minor, FW_Patch signals (8-bit Motorola unsigned each)
    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
2026-05-08 Update differential pressure scaling to ±30 psi bipolar
    Sensor output: 0.5–4.5 V, 2.5 V = 0 psid, ±30 psi span.
    Corrected formula: pressure = (raw/4095) × 60 − 30
    raw=0 → −30 psi (0.5 V sensor output)
    raw=2048 → 0 psi (2.5 V sensor output, zero point)
    raw=4095 → +30 psi (4.5 V sensor output)
    DBC Diff_Pressure signal updated: factor=0.014652, offset=−30.
    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
    [can_monitor.py, software_can_micro_python.py]
2026-05-08 Correct diff pressure scaling for 1kΩ/590Ω voltage divider
    Sensor: 0.5–4.5 V output, 2.5 V = 0 psid, ±30 psi span.
    Divider k = 590/1590 = 0.37107; at 2.5 V sensor → 0.927 V ADC.
    Sensor ADC raw at key points:
    0.5 V → raw 230 → -30 psi
    2.5 V → raw 1151 → 0 psi
    4.5 V → raw 2072 → +30 psi
    Formula: pressure = (raw/4095) × 133.398 − 37.5
    mn = -37.5 (extrapolated at raw=0)
    mx = 95.898 (extrapolated at raw=4095)
    DBC: factor=0.032576, offset=-37.5, range [-30|30]
    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
    [can_monitor.py, software_can_micro_python.py]
2026-05-08 Update Analog_In_1–6 scaling for 0.5 resistor divider front end
    All six analog input channels have a 0.5 divider (e.g. R85/R89 on
    Analog_In_1), so the actual input range is 0–6.6 V, not 0–3.3 V.
    Changed max from 3.3 → 6.6 in firmware, monitor, and DBC (factor
    0.00080586 → 0.0016117) for Analog_In_1–5 and Analog_In_6.
    Verified: 4.3 V input → raw 2644 → 4.261 V displayed (0.9% error,
    within resistor tolerance).
    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
    [can_monitor.py, software_can_micro_python.py]
2026-05-08 Fix gauge pressure (U2) scaling: 0–15 psi with 0.5 V zero offset
    Sensor outputs 0.5–4.5 V for 0–15 psi (Honeywell SCC series).
    Voltage divider ≈3.3/4.5 maps 4.5 V max to 3.3 V ADC.
    Calibration: 1.43 V ADC (raw 1775) = 5.36 psi verified externally.
    Formula: P = (raw/4095) × 16.875 − 1.875
    raw=455 → 0 psi (0.5 V sensor / 0.367 V ADC)
    raw=1775 → 5.44 psi (1.43 V ADC, within 0.08 psi of reference)
    raw=4095 → 15.0 psi (4.5 V sensor / 3.3 V ADC)
    Previous max of 150 psi was 10× too large.
    DBC: factor=0.004121, offset=−1.875, range [0|15].
    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
    [can_monitor.py, software_can_micro_python.py]
2026-05-08 Fix gauge pressure (U2) scaling for 0.5–4.5V sensor with 1kΩ/590Ω divider
    Sensor output is 0.5V at 0 psi and 4.5V at 15 psi (not 0–4V as previously assumed).
    With 1kΩ/590Ω divider (k=0.37107): raw≈230 at 0 psi, raw≈2072 at 15 psi.
    Extrapolated to raw=0: mn=-1.875 psi; to raw=4095: mx=31.474 psi.
    DBC offset updated to -1.875 to match.
    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
    [can_monitor.py, software_can_micro_python.py]
2026-05-09 Add LTSpice SPICE netlist for 3-channel K-type thermocouple thermometer
    Models the LT1014 + LT1004 + YSI 44007 reference circuit with:
    - Ideal op-amp subcircuit (swap for real LT1014 model as needed)
    - Parametric NTC thermistor using YSI 44007 beta equation
    - Three simulation modes: .op bias check, .dc gain sweep, .step CJC verification
    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
2026-05-09 Add LTSpice wrapper schematic for tc_thermometer netlist
    Minimal .asc file that includes the .cir netlist so the Run button
    is available in LTSpice (Run only activates for .asc schematic files).
    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
2026-05-09 Add K-type thermocouple EMF vs temperature plot (NIST ITS-90)
    Shows EMF (mV) and Seebeck coefficient (µV/°C) across -200 to 1372 °C
    with board operating range (0–330 °C) highlighted. Generated from
    NIST ITS-90 polynomial coefficients.
    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
2026-05-11 Switch MCP2515 to loopback mode for bench testing without CAN bus
    In normal mode the MCP2515 requires ACK from another node; without one
    it goes bus-off and holds TXCAN high. Loopback mode self-ACKs frames so
    U15 TXD activity is visible on a logic analyser with no second node.
    Change CANCTRL back to 0x00 when a terminated CAN bus is present.
    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
